loganturner/MicroDesign/img/report.pdf

# Microcomputer Design

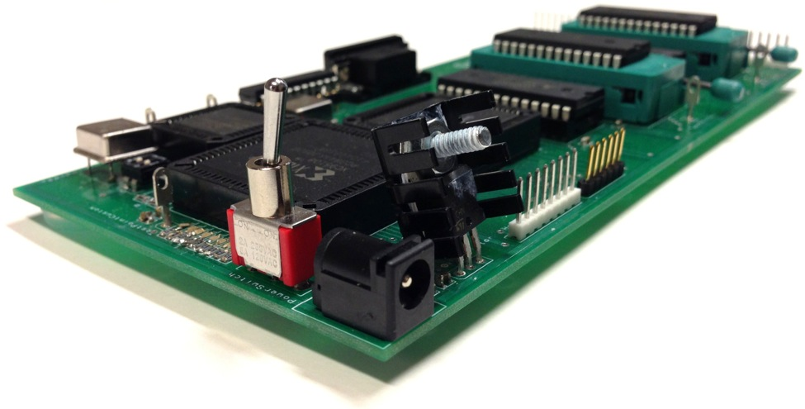
[picture p3: figure]

## FINAL REPORT

## Spring 2014

## Logan Turner

# CONTENTS

Description of Project
Hardware
- General Introduction
- Hardware Block Diagram / Board Layout
- Device and Chip Specifications
- Electrical Schematic
- Printed Circuit Board Schematic
- Parts List
Software
- General Introduction
- Memory Mapping
- Detailed Description of Core Code
- Flowchart
- Source Code
Troubleshooting

# PROJECT

The goal of Microcomputer Design is to build a single-board microcomputer using components found and integrated by the student. The student then designs an electrical schematic and printed circuit board, connects the components to the circuit board, and writes software for the computer in order to demonstrate that it works.

# HARDWARE

## Board Layout

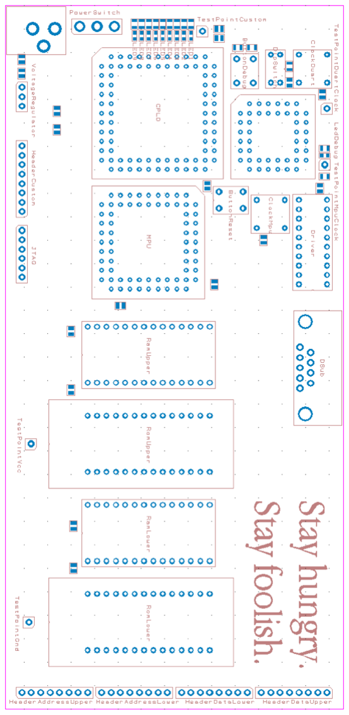
[picture p4: figure]

(actual size)

## Device and Chip Specifications

Microprocessor
Motorola 68k (MC68000CFN)
clocked at 12 MHz, rated for 16 MHz
68-pin PLCC package manufactured by Freescale Semiconductor

Complex Programmable Logic Device (CPLD)
Xilinx XC95108-7PC84C
72 macrocells
84-pin PLCC package

Read-Only Memory (ROM)
Atmel EEPROM - AT28C256-15PU 2 chips x 32 kB
150 ns response time
28-pin DIP package

Random-Access Memory (RAM) Alliance SRAM - AS6C62256-55PCN 2 chips x 32 kB
55 ns response time
28-pin DIP package

Dual Universal Asynchronous Receiver / Transmitter (DUART) SCC68681 UART Interface - C1A44,518
2-channel, running at 115.2 kbaud
serial interface
44-pin PLCC package manufactured by NXT

## Electrical Schematic

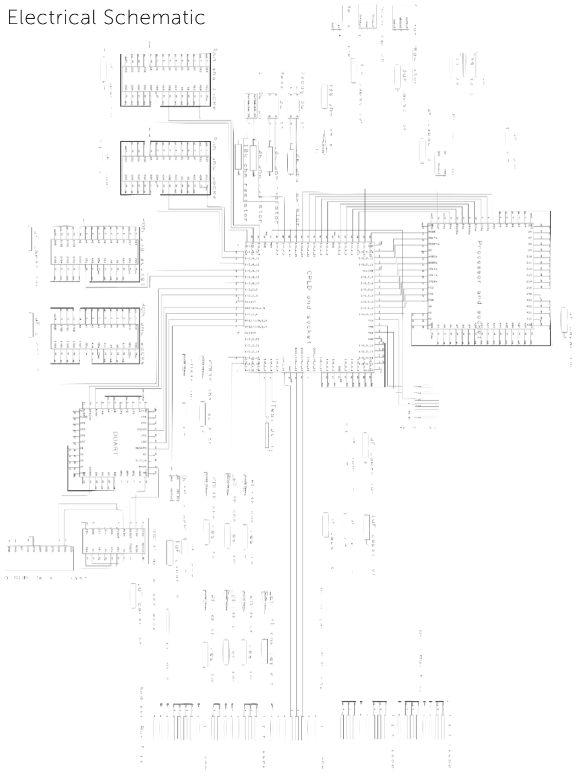
[picture p5: page 6]

## Printed Circuit Board Schematic

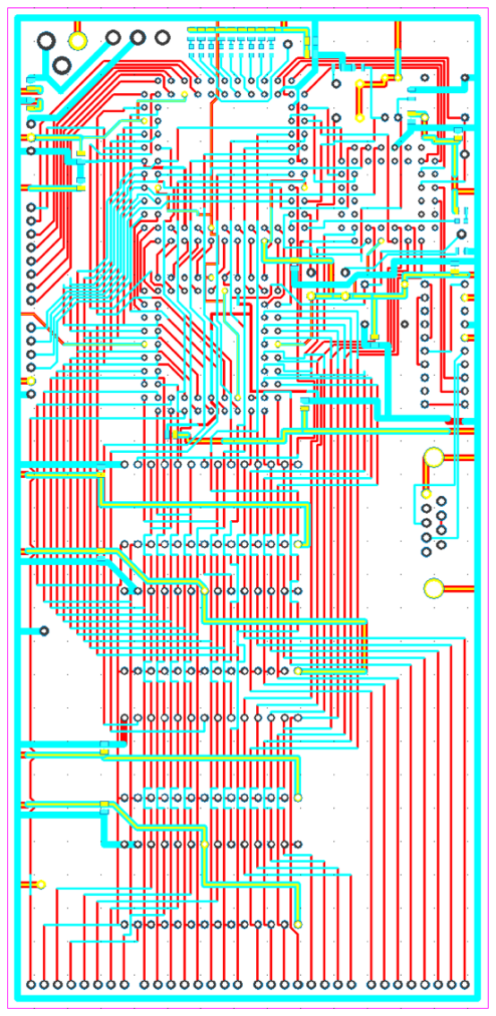
[picture p6: figure]

(actual size)

## Parts List

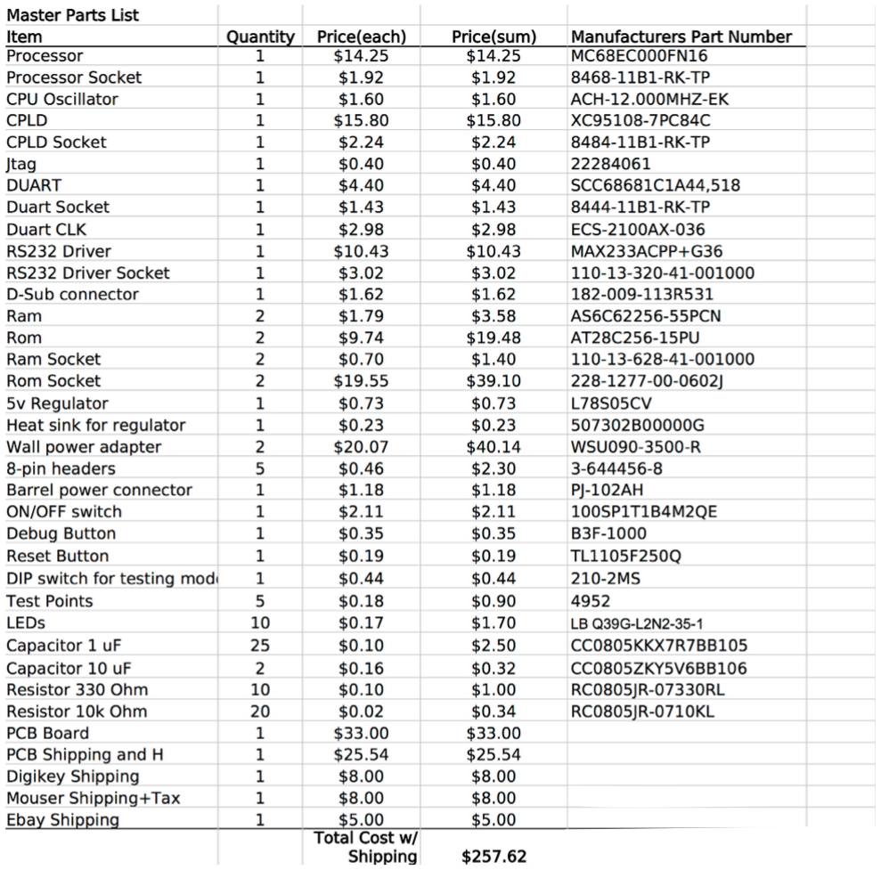
[picture p7: figure]

# SOFTWARE

## General Introduction

All software was written by hand in 68k assembly and tested using the Easy68k emulator. The three required pieces of functionality were:
- Modify any register in the 68k
- Modify any location in RAM
- Upload an S-record through the serial port and run it in RAM

## Memory Mapping

Since both RAM and ROM consisted of two chips with 32 kB apiece, ROM was allotted the first 32kB, and RAM was allotted the second. Address line 17 selects between memory and the DUART, and Address line 16 selects between RAM and ROM.

## Flowchart

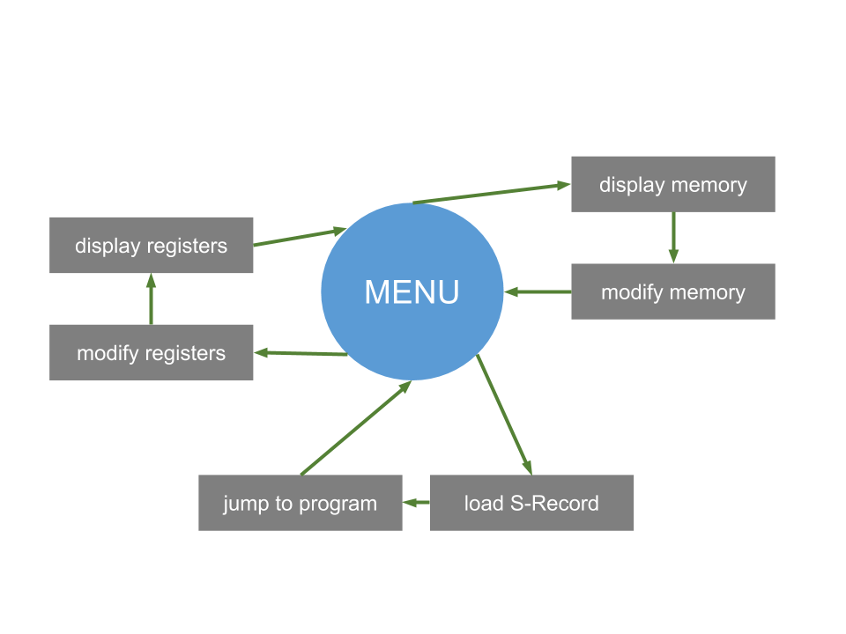
[picture p8: figure]

## Source Code

Source code available at http://github.com/loganturner/MicroDesign

# TROUBLESHOOTING

Overall, few problems were encountered.
On the hardware side, the first DIP socket ordered for the RAM was the wrong width, so another socket had to be ordered. Also, the CPU oscillator was initially soldered in the wrong orientation, and had to be de-soldered and re-soldered correctly. Finally, during the public presentation, the serial driver chip came loose in its socket, causing serial communication to fail.
In software, a few hours were spent trying to reconcile differing behavior between the Easy68k simulator and the actual hardware. The fix ended up having two different sets of subroutines specified in the code, with one set selected at assembly time.
