loganturner/MicroDesign/img/layout.PNG

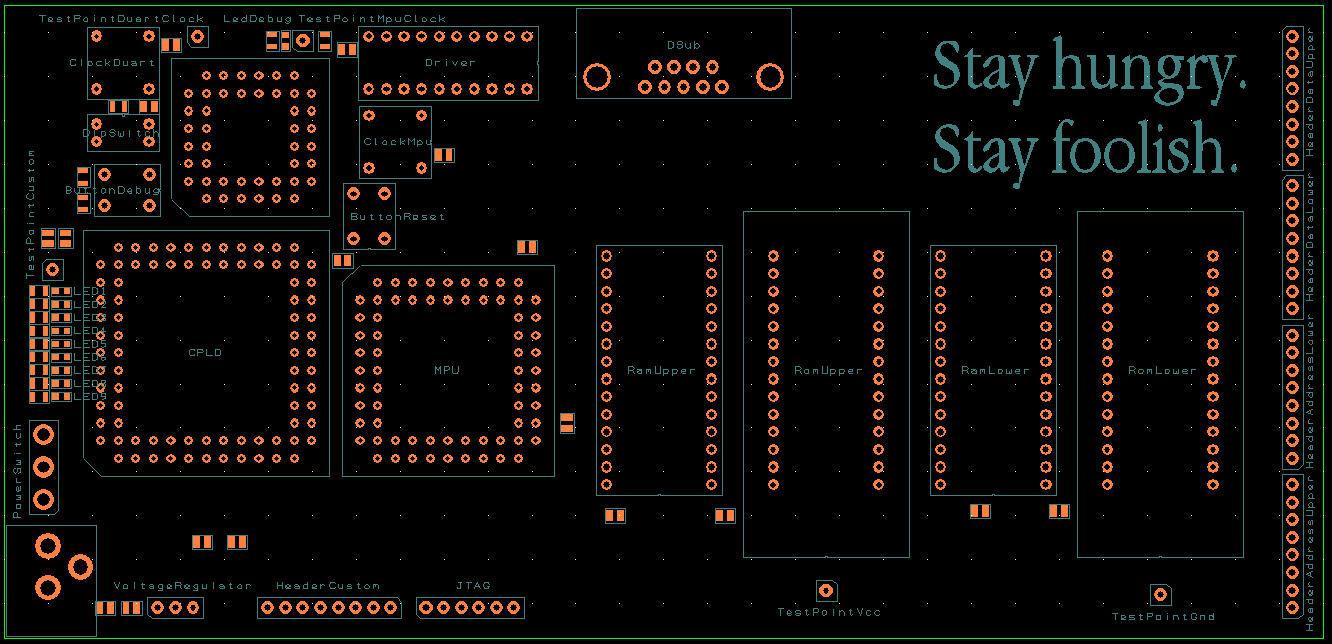
img/layout.PNG
