loganturner/MicroDesign/img/schematic-final.png

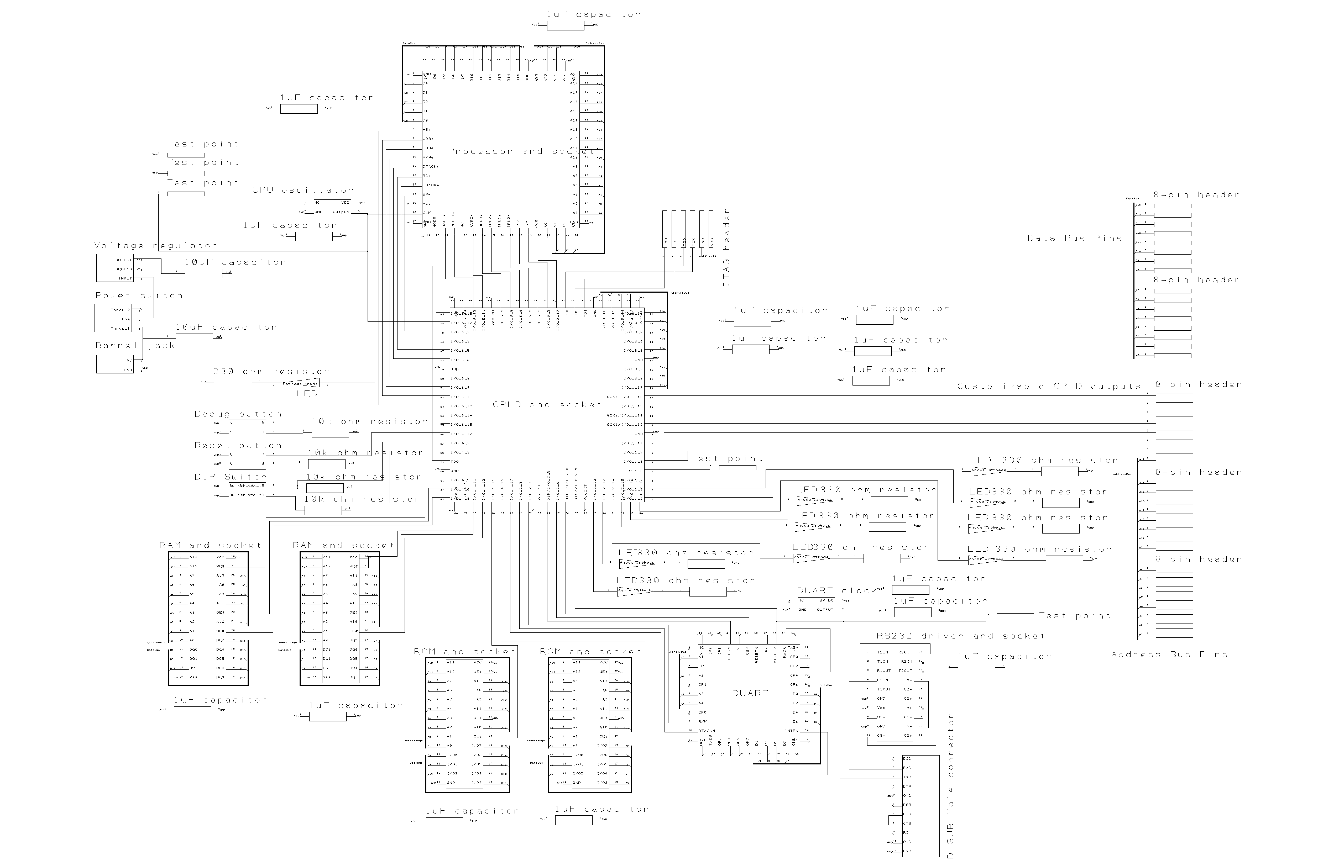
img/schematic-final.png
