loganturner/MicroDesign/(list of files, drawings)

Other design files:
Schematic and PCB/microcomputer.pcb
