loganturner/MicroDesign/(threads)

Thread 1 (2015-05-13):

VHDL_CPLD Pin Configuration Bug

idflores, 2015-05-13:
Using the following CPLD, normal pin configuration was found to be defective:
CPLD Part Number:   XC95108-PC84AKJ0920-F1046838A-15C

The following changes were applied:
Change Report:
CPLD_Pin#11  -->  CPLD_Pin#63
CPLD_Pin#21  -->  CPLD_Pin#65
CPLD_Pin#23  -->  CPLD_Pin#67
CPLD_Pin#24  -->  CPLD_Pin#69
CPLD_Pin#20  -->  CPLD_Pin#70

Closed 2015-10-24.
