loganturner/MicroDesign/(commit log)

2014-04-01 Insert logo, trying to get arrow keys to work
2015-03-27 Add schematic, PCB, and VHDL code.
    [microcomputer.pcb, microcomputer.sch]
2015-04-01 Realized that I had uploaded old, unfinished VHDL. Here's what went into my final computer.
    [busybody_pad.csv]
